oliviacarino/Tengwar/(list of files, cad)

Other CAD files:
mech/STL/files/Cartesian_Plotter.f3z
