oliviacarino/Tengwar/(commit log)

2026-02-23 update readme with v1 physical and circuit designs
2026-02-23 Add readme and images directory
    First physical and circuit designs.
2026-02-23 Add socket, power to RAMPS in circuit design
2026-02-23 Upate circuit image
2026-02-23 Add correct image for circuit design
2026-04-04 Add draw_cal_template function, prints matrix to terminal for now
2026-04-04 update and test serial connection to arduino
2026-04-04 fix missing call to send_command
    [main.py, serial_comms.py]
2026-04-05 add custom firmware for arduino and ramps 1.4 sheild
    [Configuration.h, Configuration_adv.h]
2026-10-10 add stl files
2026-10-11 add updated stl files
2026-10-11 create initial assembly file with design overview
2026-10-11 add partial BOM
2026-10-11 add printed parts list
2026-10-11 link STL files to printd parts list
2026-10-11 rename assembly file
